dmckinnon/PicoGPT/README.md

# PicoGPT
I’ve wanted to learn more about the optimisation techniques that go into running modern LLMs on specialised hardware for a long time, so I recently did a technical deep dive. This involved creating and training a small (few megabytes) GPT-architecture model, which got me thinking: could I optimise such a model to run on something small? What's the smallest thing I could get a reasonable GPT to run on? 

Lo and behold, I give you a Generative Pretrained Transformer running on an ARM Cortex M33, at ~50 tokens per second generation. Let's dive in to how I achieved this.

## Contents
- [Introduction](#introduction)
- [Model structure, size, and training](#model-structure-size-and-training)
- [Porting from tflite to C++](#porting-from-tflite-to-c)
- [Can this run at all](#can-this-run-at-all)
- [Optimisations](#optimisations)
- [Circuit design and fabrication](#circuit-design-and-fabrication)
- [Conclusion](#conclusion)
- [Usage](#usage)

## Introduction
To learn deeply about LLMs I went to none other than [Karpathy](https://karpathy.ai/), his [youtube series](https://www.youtube.com/playlist?list=PLAqhIrjkxbuWI23v9cThsA9GvCAUhRvKZ) on basic LLM architecture, and of course, his [NanoGPT repository](https://github.com/karpathy/nanogpt). This is an excellent way to learn as Karpathy is clear, goes through simple steps, and the repository provides an easy playground to mess with parameters and model structure - one can see which changes affect what, like different numbers of attention heads, layers, context length, etc. The rest of this writeup assumes a considerable familiarity with the topics Karpathy goes over, Language Model architecture, Attention Heads, embedding vectors, tokens, etc. (For those who don't like youtube videos, my own writeups, mostly for my understanding, can be found [elsewhere](https://dmckinnon.github.io/LLMs-overview/) on my [site](https://dmckinnon.github.io/Tokenisation-in-LLMs/))

I'd also recently finished my [Machine Learning Business Card](https://dmckinnon.github.io/ML-Business-card/), and was struck by the thought: _could I make a NanoGPT model that ran on one of these cards?_

There's so many considerations involved in this:
- what does such a model even do? Is it too small to do anything?
- can you get a meaningful model that small? The voice recognition card has 4MB flash and ~200Kb RAM
- The base shakespeare-predictor model that NanoGPT creates, completing phrases from the works of Shakespeare based on character-tokens in a prompt, is ~40~Mb in size, with ~10 million parameters. 
- how fast will this run? My lil chip runs at 125MHz. The NanoGPT example runs on my laptop in functionally-immediate speed, but my laptop has a discrete GPU.

There's two main challenges:
1. Creating a model that can, at minimum, fit into the flash of this chip (4Mb), and probably needs to be smaller, but that also can generate coherent english sentences.
2. Getting such a model to run in real time on this tiny chip 

So, where to start? 

## Model structure, size, and training
First, can we even create a model that's really small and does something useful? I set myself a size budget of 100Kb - as in the model file (all model parameters) could not be larger than this - and twiddled with the base model. This budget comes from being ~half the RAM of the RP2040 - I'm eyeballing and thinking the code won't take much, and then we need some memory for stack, heap, etc, so 100kb seems like a good amount to aim for a priori.\ 
But what should we train it on? 100Kb model, predicting Shakespeare? That's boring, that's not much Shakespeare and also who cares. Some other pithy quotes? Amusing, but no. 

What about ... me? What if we trained the model to regurgitate facts about me? Going back to the business card idea, wouldn't it be great if my business card could just ... speak my resume to people and answer queries about that? 

I loved this idea, so I wrote up my CV, writ small (100Kb model, remember, it's not learning much), to use as the training set. 

### The base model
If we just run the prompts Karpathy has given us, to predict Shakespeare, then we get a model with:
- vocab size 65
- dataset length 1 million
- 6 layers in the model
- 6 attention heads
- 384 embedding dimensions
- ~ 10 million parameters
- ~40Mb in storage as float

### My model
The training data is the following:

```
David studied at UNSW Univeristy of New South Wales from 2012 to 2016\
What did he study?
He studied engineering and mathematics, focusing in robotics and computer vision 
David worked at Microsoft from 2016-2023
What did he work on?
At Microsoft he worked on HoloLens, using feature tracking.
At Microsoft he experimented with constellation tracking and non-inertial tracking
David work at startup Tetra in 2023
At Tetra he worked on ML graph passes, op implementations, and model zoo
David worked at Qualcomm in 2024
At Qualcomm he worked on ML graph passes and op implementations
```

dataset stats:
- length of dataset in characters: 582
- all the unique characters:  ,-.012346?ADHLMNQSTUWabcdefghiklmnoprstuvwxyz
- vocab size: 47 unique tokens, where each token is a single character

Couple notes:
- Why the questions? So that this could be legitimately queried, like a prompt could be those precise questions
- "doesn't this contain a lot of redundancy?". Yes. Yes it does. The tokenizer I'm using tokenises by characters. I want there to be examples where the characters "experimented" follow "he", but also the characters "studied" follow "he", and so on and so forth. 
- This is succinct because the model is 100kb at most, like I really have to squish it down
- Could we have more? Not sure, let's start here. I wasn't sure at the time how good a 100Kb model would be. Worst case is we overfit to this, and if this happens, I'll train on a bigger dataset

I played around with parameters. How many heads? How many embedding dimensions? How many layers? There are so many experiments to run, and I definitely did not exhaustively find the best set of parameters. But that's not my goal - I just want _something that works_. I found that the following worked:

- 1 attention head per layer
- 2 layers
- 32 embedding width
- context length 31, using a sliding window context
- 27,232 parameters
- 107Kb in storage as float

By "worked" here I mean:
- it produced reasonable predictions when prompted ... although to be honest, it's so overfit it's just regurgitating the training data. TODO examples
- it "fits" within the memory budget I have: 100Kb (ok it's 107Kb but this is close enough, I'm going to work with it)

This is a good start! Maybe I want to return to this step for a better model, but this easily fits within the flash we have - 4Mb, the matrices for individual steps fit within the RAM budget, and the results look good. So before I stress too much over getting the perfect model, let's attempt implementation. 

## Porting from tflite to C++
When running the model in NanoGPT's sample.py, there are two parts. One is the actual forward pass of the transformer, which produces a vector of logits, and the other is a loop that runs softmax over these logits, finds the probability of each vocab entry (token), samples from a distribution to get the next token, and then runs the next forward pass over the new token set. 

The first part, the actual forward pass of the transformer, is the model inference and it's here we use the model weights. The rest is just math. So to extract the model - the set of all weights, and structure of tensors and operations - in sample.py I use the following python code, where `model` is the `torch.nn` object whose `forward` function is the transformer pass inside the `mode.py` `generate` function:

```
traced = torch.jit.trace(model, x)
torch.jit.save(traced, "traced_model.pt")
```

This produces a pytorch file. Are we going to manually copy the weights from this? Well, no.\
Pytorch files are not particularly well optimised, having many redundant layers like transposes that are later cancelled by other transposes, or cast ops to int, or whatever:

[](pytorch.png)

I'd like to clean this model up, and made it easier to understand, for starters. Qualcomm has this marvellous platform called [Qualcomm AI Hub](https://workbench.aihub.qualcomm.com/) that can [optimise a model for a device](https://workbench.aihub.qualcomm.com/docs/hub/compile_examples.html).\
(Disclosure: no, I'm not sponsored by Qualcomm. I used to work on this product, however, and just genuinely think it's really useful)\
While the device I'm optimising for isn't available - they only have a selection of Qualcomm chips, funnily enough - this doesn't matter. All I'm really hoping to do is to strip the unnecessary layers from the model. We run it through their platform 

[](tflite1.png)

[](tflite2.png)

[](tflite3.png)

and now we have a tflite file! This is considerably cleaner, so the Qualcomm optimisation pass was worth it, even just for readability. From this we can identify the different parts of the transformer in each layer and consider the code for each part. 

### Layernorm
- the [layernorm](https://docs.pytorch.org/docs/2.15/generated/torch.nn.LayerNorm.html) op. Straightforward elementwise mathematical operation. (TFLite does not natively have a Layernorm op, and so breaks this out into constituent operations). This is\
$y=\frac{x-\bold{E}[x]}{\sqrt(Var[x]+\epsilon)}\times\gamma +\beta$\
The point of this operation is to normalise the data after each other operation, so there's a few of these.

```
for (size_t seq = 0; seq < seq_len; seq++) {
    const float* input_row = input + seq * embed_dim;
    float* output_row = output + seq * embed_dim;
    
    // Compute mean
    float mean = 0.0f;
    for (size_t i = 0; i < embed_dim; i++) {
        mean += input_row[i];
    }
    mean /= embed_dim;
    
    // Compute variance
    float variance = 0.0f;
    for (size_t i = 0; i < embed_dim; i++) {
        float diff = input_row[i] - mean;
        variance += diff * diff;
    }
    variance /= embed_dim;
    
    // Normalise
    float inv_std = 1.0f / sqrtf(variance + epsilon);
    for (size_t i = 0; i < embed_dim; i++) {
        output_row[i] = gamma[i] * (input_row[i] - mean) * inv_std + beta[i];
    }
}
```

### Q/K/V
- Q/K/V matrix multiplications with the embedding vectors. Matrix $\times$ vector, simple. By keeping the vectors consecutive in memory, we create a matrix, and can just use our matrix multiplication function to do this:

```
static inline void matmul(
    const float* A, size_t rows_a, size_t cols_a,
    const float* B, size_t cols_b,
    float* C
) {
    for (size_t i = 0; i < rows_a; i++) {
        for (size_t j = 0; j < cols_b; j++) {
            float sum = 0.0f;
            for (size_t k = 0; k < cols_a; k++) {
                sum += A[i * cols_a + k] * B[k * cols_b + j];
            }
            C[i * cols_b + j] = sum;
        }
    }
}

// Then to actually do the QKV projection:

const float* q_weights = qkv_weights;                           // [0:embed_dim, :]
const float* k_weights = qkv_weights + embed_dim * embed_dim;   // [embed_dim:2*embed_dim, :]
const float* v_weights = qkv_weights + 2 * embed_dim * embed_dim; // [2*embed_dim:3*embed_dim, :]

// Project to Query
matmul(input, seq_len, embed_dim, q_weights, embed_dim, query);

// Project to Key
matmul(input, seq_len, embed_dim, k_weights, embed_dim, key);

// Project to Value
matmul(input, seq_len, embed_dim, v_weights, embed_dim, value);
```

### Scaled Self-Attention
- Scaled self-attention\
[image]
This is the key attention equation:\
$Attention(Q, K, V) = softmax(\frac{QK^T}{\sqrt{d_k}})V$\
We could break this down further into a matrix multiplication, a scaling, and another matrix multiplication, but I think it's better to keep it all as one function because then we can smoosh a bunch of things together. 

```
static inline void softmax(float* input, float* output, size_t length) {
    // Find maximum value for numerical stability
    float max_val = input[0];
    for (size_t i = 1; i < length; i++) {
        if (input[i] > max_val) {
            max_val = input[i];
        }
    }
    
    // Compute exponentials and sum
    float sum = 0.0f;
    for (size_t i = 0; i < length; i++) {
        output[i] = expf(input[i] - max_val);
        sum += output[i];
    }
    
    // Normalize
    for (size_t i = 0; i < length; i++) {
        output[i] /= sum;
    }
}

// then to perform attention

const float scale = INV_SQRT_HEAD_DIM; // 1/sqrt(embed_dim)
    
// Compute Q * K^T / root(embed_dim)
// query: [seq_len, embed_dim], key^T: [embed_dim, seq_len] -> scores: [seq_len, seq_len]
for (size_t i = 0; i < seq_len; i++) {
    for (size_t j = 0; j < seq_len; j++) {
        float sum = 0.0f;
        for (size_t k = 0; k < embed_dim; k++) {
            sum += query[i * embed_dim + k] * key[j * embed_dim + k];
        }
        attention_scores[i * seq_len + j] = sum * scale;
    }
}

// Apply causal mask and softmax for each query position
for (size_t i = 0; i < seq_len; i++) {
    float* score_row = attention_scores + i * seq_len;
    
    // Apply causal mask (can only attend to previous and current positions)
    for (size_t j = i + 1; j < seq_len; j++) {
        score_row[j] = -INFINITY;
    }
    
    // Apply softmax to this row
    softmax_inplace(score_row, seq_len);
}

// Apply attention weights to values: output = attention_scores * value
// attention_scores: [seq_len, seq_len], value: [seq_len, embed_dim] -> output: [seq_len, embed_dim]
for (size_t i = 0; i < seq_len; i++) {
    for (size_t j = 0; j < embed_dim; j++) {
        float sum = 0.0f;
        for (size_t k = 0; k < seq_len; k++) {
            sum += attention_scores[i * seq_len + k] * value[k * embed_dim + j];
        }
        output[i * embed_dim + j] = sum;
    }
}

```

### Feed-Forward Network
- Feed Forward Network [image]. This is just a matrix multiplication (`Fully Connected`), a [GELU](https://docs.pytorch.org/docs/2.15/generated/torch.nn.GELU.html) elementwise operation, and then another matrix multiplication. A lot of matrix multiplication happening all over the place, so an obvious point to start improvements.

```
matmul(input, seq_len, embed_dim, up_weights, ffn_dim, hidden);
    
// Apply GELU activation in-place
apply_gelu(hidden, seq_len * ffn_dim);

// Second linear layer: output = hidden * down_weights  
// hidden: [seq_len, ffn_dim], down_weights: [ffn_dim, embed_dim] -> output: [seq_len, embed_dim]
matmul(hidden, seq_len, ffn_dim, down_weights, embed_dim, output);
```

### Residual Skip Connection
This is the `Add` operation joining those two branches together. We take the input to the whole layer, before any attention or feed-forward, and add it with the output of the whole layer.

```
static inline void add_tensors(
    const float* A,
    const float* B,
    float* C,
    size_t length
) {
    // Yeah this one's pretty simple
    // The vectors are so short it's practically not worth optimising
    for (size_t i = 0; i < length; i++) {
        C[i] = A[i] + B[i];
    }
}

// This comes in after FFN, for example
float* ffn_output = ffn_op(arena, normalized_input, up_weights, down_weights, 
                              seq_len, embed_dim, ffn_dim);
size_t total_elements = seq_len * embed_dim;
add_tensors(input, ffn_output, output, total_elements);
    
```

### Gather
This is simply indexing into an array. "Here's some indices for vocab elements, get the vocab elements they refer to".

### Putting it all together
Now all we need to do is connect those parts ... 

```
// inside Attention with residual:
qkv_projection(input, qkv_weights, query, key, value, seq_len, embed_dim);
    
// Step 2: Scaled Dot-Product Attention
scaled_dot_product_attention(query, key, value, attention_output, 
                            attention_scores, seq_len, embed_dim);

// Step 3: Output Projection
attention_output_projection(attention_output, output_weights, final_output, 
                               seq_len, embed_dim);

// Step 4: residual
size_t total_elements = seq_len * embed_dim;
add_tensors(input, attention_output, output, total_elements);

// inside FFN with residual:
layer_norm(input, normalized_input, ln_gamma, ln_beta, seq_len, embed_dim, LAYER_NORM_EPS);
float* ffn_output = ffn_op(arena, normalized_input, up_weights, down_weights, 
                              seq_len, embed_dim, ffn_dim);
size_t total_elements = seq_len * embed_dim;
    add_tensors(input, ffn_output, output, total_elements);

// Running one full layer:
// (repeat for n layers, and update parameters accordingly)
float* attn_output = attention_with_residual(
    arena, input, attn_qkv, attn_out, ln_gamma_1, ln_beta_1,
    seq_len, config->embed_dim
);

// FFN with residual connection
float* layer_output = ffn_with_residual(
    arena, attn_output, ffn_up, ffn_down, ln_gamma_2, ln_beta_2,
    seq_len, config->embed_dim, config->ffn_dim
);

```

and thats the whole model! 

## Can this run at all

Is it actually that simple? Well, let's see if this runs at all. For my first ML-on-business-card I used the [RP2040](https://pip-assets.raspberrypi.com/categories/814-rp2040/documents/RP-008371-DS-1-rp2040-datasheet.pdf), but it does software emulation of floating point hardware - that is, floating point math is actually done with 32-bit integers emulating what a dedicated floating point logic gate circuit would do. Software-floating-point will work, but be slow. Coincidentally, the next generation, the [RP2350]() chip had just come out, and this one came with a FPU coprocessor - floating point hardware! So floating point arithmetic could be performed in a single clock cycle. A dev board was acquired, a compiler was run (and run and run and run and eventually the code compiled), a chip was flashed, aaaaaand ...

|Input context length |	Time per next token |	Tokens/second
|---|---:|---:|
|5 tokens |	25.473 ms |	39.26
|7 tokens |	30.128 ms |	33.19
|10 tokens |	37.315 ms |	26.80
|31 tokens |	92.209 ms |	10.85

10 tokens per second!! For a basic implementation, that's a lot more than I was expecting. I'm ignoring the low context lengths, because those are not particularly useful. We want full sentences, and when a single token is a single character ... 5 characters doesn't get you much. 31 characters does. 

So, what do we do from here? Is this it? It runs, produces sentences, yay done move on?\
Absolutely not! Now we need to see just how fast we can get this model running. The main metric I'll use is tokens per second on prompt processing and decode processing, but as decode is a fixed 31-length sliding window, it doesn't make much of a difference. 

There are a number of optimisations I have in mind: multithreading, unrolling, removing intermediates, RAM residency, quantisation. The next section will go through everything I tried, including failures. 

## Optimisations

There are several benchmarks I'm using here. For some things like matrix multiplication, we can easily create a standalone benchmark. I'm also giving the model a small prompt and generating 100 output tokens based on this prompt, and we'll see how that is affected each time. 

All optimisations were also checked for accuracy, both on numerical benchmarks (computing matrices etc) and also checking token-generation output. While the output logits (the values directly from the final layer) changed slightly, the difference was never enough to change the final probabilities for each token, for the next prediction. Only optimisations that maintain this accuracy are considered. 

There are a couple of optimisations some notice are missing here; namely, quantisation and KV caches. I did consider these and ultimately rejected, and I'll address that briefly:
- Quantisation.\
Quantisation involves squashing my nice and accurate floating points into discrete little int8s. The advantages of this are namely storage - I could have four times as many parameters for the same flash size - and processing speed, as I could use the M33's DSP to do SIMD operations on int8 data, computing 4 results within one clock cycle. However, there's an accuracy cost to quantisation, and given the speeds I ended up getting with floating point, I did not consider the accuracy hit worthwhile at this stage. Perhaps for V2, where I want to attempt a bigger model.
- KV Cache\
One common optimisation in the LLM-implementation field is that of a KV cache. When generating tokens after the prompt, since we have already run over the attention of previous tokens to other previous tokens, this does not need to be recomputed, so we, well, cache the result of this and simply compute the K/V results for any new tokens. I decided against this one. Firstly, when generating tokens, I use a sliding window context of 31 tokens - therefore, any results older than 31 tokens become irrelevant, and we need to recompute the 31-token attention anyway, or do complex cache management. Recomputing is easier. Secondly, 31-token context is simply not large enough to warrant the complexity of a KV cache.

### Cache-coherent matmul
Both attention and Feed-Forward Networks rely on matrix multiplication. My thought was that to optimise for cache-coherency, as matrices tend to be stored linearly, we could write out one row of output at a time - keeping the whole row in cache - and therefore keep one row of matrix $A$ in $C = A\times B$ resident in cache as well, whilst iterating through the columns of B. That second iteration would have cache misses, but no more so than a regular iteration keeping one column of B, iterating through rows of A and rows of output. 

A nice idea in theory; it turns out, from the [datasheet](https://support.arm.com/documentation/100230/latest/) that the ARM Cortex M33, that the RP2350 is based on, has no CPU cache, and therefore ... this is irrelevant. Oh well. A nice idea.

### SRAM Residency
The RP2350 fetches weights from flash and places them into SRAM to do the matrix calculations. There is a 16 KiB cache for this, buuuuut ... what if we avoided that fetch? Each fetch from flash has a delay due to the cache (could have a miss) and the QSPI memory interface. It's not large, but we have 500Kb of SRAM and a 107Kb model. We can fit this entirely within RAM once upon startup - incurring a one-time cost - but then reuse weights with abandon, processing as many new tokens as we see fit without any extra fetch overhead. 

To achieve this, we just use a linker setting: `-DPICO_DEFAULT_BINARY_TYPE=copy_to_ram`\
Or in CMake, `pico_set_binary_type(PicoGPT copy_to_ram)`. \
This then copies all application code and constants, like weights, into SRAM upon boot. We could manually write a copy, but I prefer to not reinvent the wheel (or the memcpy).

Here's the timing, with and without:
|Configuration	|Time per token, 31-token context|	Tokens/s|
|---|---:|---:|
| baseline, flash/XIP|	79.852 ms|	12.52|
|SRAM code + weights|	63.907 ms|	15.65|

A considerable improvement! An expected one, but nonetheless rewarding to see. 

### Unrolling
This is essentially pipelining loops. Consider a standard matmul loop:

```
for (B matrix rows)
    for (A matrix cols)
        for (C matrix position)
            C[i,j] += a*b
```

In the inner-most loop, we do one multiplication, one addition, one store, and then check loop conditions, have a potential branch, and set up the loop again. There's almost as much overhead as there is loop calculation!

What if we were to do more per loop? Consider:

```
for (B matrix rows)
    for (4 A matrix cols)
        for (4 C matrix positions)
            C[i_1,j_1] += a_1*b_1
            C[i_2,j_2] += a_2*b_2
            C[i_3,j_3] += a_3*b_3
            C[i_4,j_4] += a_4*b_4
```

We've essentially batched this matmul, doing 4 at a time. Obviously this requires the size to be divisible by 4, but we know the size a priori so we can make this work. Now we do 4 multiplications and 4 additions per loop overhead! The multiplications in the Floating Point coprocessor take a couple of cycles, but there are multiple floating-point registers we can use so these multiplies can be pipelined so we hide the delay on those registers behind the next multiply:

```
Example with unrolling 2 at a time

Before:
cycle 1: R0 = R1*R2
cycle 2: R0 locked behind second cycle  of multiply, nothing happens
cycle 3: R4 += R0
cycle 4: loop stuff

After:
cycle 1: R0 = R1*R2
cycle 2: R0 locked, R5 = R6*R7
cycle 3: R4 += R0, R5 locked
cycle 4: R8 += R5
cycle 5: loop stuff
```

In this 'after', there's no cycle where we are just waiting - we're always doing something. This may seem small, but recall it's the inner loop of three nested loops so this happens a lot. And that's just one matmul, of three matmuls per layer, for two layers, per token. The time saving should add up. 

Does it? Let's take a look at the results:

|Configuration|	Time/token|	Tokens/s|	Speedup vs flash baseline|
|---|---:|---:|---:|
|Flash/XIP baseline|	79.852 ms	|12.52	|1.00×|
|SRAM code + weights|	63.907 ms|	15.65|	1.25×|
|Four-way matmul unrolling: FFN and attention projections|	40.826 ms	|24.49	|1.96×|

As expected, we get gainz. That's enormous though! 

What can be unrolled?\
Any loop, really. Matrix multiplications, elementwise operations like tensor addition or GELU, parts of the softmax function. Unroll everything! I realised later that I had forgotten some of the loops to unroll here, and so our speedup is technically even more.

### Fused Multiply-Accumulate
Can we make the inner loop of matmuls even faster? Until now, this inner loop of the matrix multiplication has been using two instructions: floating point multiply, and floating point add. \
But there's an important feature in this floating point coprocessor: [Fused Multiply-Accumulate](https://pip-assets.raspberrypi.com/categories/1214-rp2350/documents/RP-008373-DS-3-rp2350-datasheet.pdf), also known as `FMA` (Section 3.7.2.4).

This does exactly as it sounds, performing a multiply and accumulate (+=) all in one instruction. This should make our inner loop have half the number of instructions! That's twice as fast! It's a relatively simple change, just a compiler flag:

```
# Specifically, the ffp-contract=on is the FMA.
target_compile_options(PicoGPT PRIVATE
    -Wall -Wextra -O2 -fstack-usage -ffp-contract=on
)
```

And this will replace floating point multiplies followed by accumulates with the single instruction. 

Check results, and note that this is on top of unrolled loops:

|Measurement|	FMA off|	FMA on|	Change in elapsed time|
|---|---:|---:|---:|
|Scalar attention-projection matmul	|1.836 ms	|1.624 ms	|11.5% less|
|Four-way attention-projection matmul|	0.945 ms|	1.168 ms|	23.6% more|
|Four-way FFN-up matmul	|3.767 ms|	4.659 ms	|23.7% more|
|Generate 100 tokens, inference only	|3.432 s|	3.612 s|	5.2% more|

Oh.\
This is slower, overall.\
Hmm. \
Why is this slower?

I dug a bit but not enough to properly figure it out. It was faster than the single-multiple-accumulate per loop, but not faster than unrolling. My theory is that it uses more registers and slowed down the unrolled version with register swaps? No evidence to support this. I could dig into the assembly, but we got such a massive win from unrolling and there's more to try that if all else fails I'll come back, but otherwise ... meh. Chalk this one up as a loss. 

### Removing Intermediates/Fusing
The concept behind this idea is that we are constantly performing an operation, like adding two tensors, and then writing the result out to a third tensor in memory. The next operation will read this back from memory, perform something else on it, like some elementwise operation, and then write it back out again. \
There's a lot of inefficiency here. What if we fused the two? That is, what if we didn't have the intermediate tensor?\
For example, after FFN we have the residual skip-layer, where we add the tensor from the start of the layer back into the result from the layer. We could complete the matmul, write that out, and then loop through the tensor again and element-wise add. \
Or\
We could, while performing the matmul, add the residual to the layer-input tensor at the output of the matmul, and thereby avoid a whole separate iteration through the tensor?

Let's see this in code:

```
Before:
for (rows of B)
    for (cols of A)
        for (elems in dot product)
            C[i] += a*b

for (elems in tensor)
    C[i] += input[i]

After:
for (rows of B)
    for (cols of A)
        for (elems in dot product) 
            C[i] += a*b
            C[i] += input[i]
```
We still have to do all the operations, but what this saves is all the loop overhead - not just in an unrolling fashion, but ALL the loop overhead of a second loop. \
We can do this for the two residual skip-connections, and also the GELU operation in the middle of the FFN. 

Let's check these separately:

|FFN configuration|	Full-context time/token	|Tokens/s|	100-token inference|
|---|---:|---:|---:|
|Before fusion|	40.826 ms	|24.49	|3.432 s|
|Buffer reuse + fused residual and fused GELU|	41.863 ms	|23.89	|3.517 s|
|Buffer reuse + fused residual, separate GELU	|40.330 ms	|24.80	|3.388 s|

So the skip connection fusing works, albeit for a marginal gain. Why doesn't GELU? GELU uses the [C++ `erff` function](https://en.cppreference.com/cpp/numeric/math/erf), which is register heavy. This works on its own, but when we are trying to preserve four separate accumulated values ... that costs extra registers which therefore cannot be used during a register heavy function. I didn't dig into the assembly here, but my best guess is that there was some use of SRAM to hold register values while `erff` was computed, reducing time savings under fused-unrolling.

Oh well. We can still unroll the GELU on its own and get an already-proven win there - that is, finish the unrolled matmul, save an intermediate, perform GELU unrolled on its own loop (so each of four `erff` calls in the loop has full register access), and then move on to the next matmul. How does this perform?

|Configuration|	Time/token	|Tokens/s	|Speedup vs flash baseline|
|---|---:|---:|---:|
|Flash/XIP baseline	|79.852 ms|	12.52	|1.00×|
|SRAM code + weights|	63.907 ms|	15.65	|1.25×|
|Four-way matmul unrolling: FFN and attention projections|	40.826 ms	|24.49|	1.96×|
|FFN buffer reuse, fused residual, separate GELU|	40.330 ms	|24.80	|1.98×|

The fused residual is a pretty small gain, but again - doesn't hurt us, doesn't overly complicate the code, so I'm going to keep this in.

### Multithreading
Another seemingly obvious win. Until now, all algorithms have run on a single core - which we needed to clearly know what the speedup was, so this one has to come last. 

The Cortex M33 has two cores, each with a floating point coprocessor. There are no CPU caches, as mentioned previously, and both cores just read and write directly to SRAM. All we need to do is split the loops we intend to multi-thread correctly so no memory contention occurs, and this should just fall into place. We'll multithread the matrix multiplication loops - unrolled and with fused intermediates, so this means multithreading several implementations - and try the elementwise GELU loop. The softmax ... is finicky enough and doesn't take enough time for this to be worth it. I profiled the whole thing, and matmul dominates. Softmax was a mere 5% of time, to the ~60% of time spent on matmul. 

How should we split up the matrix multiplication? GELU loop is easy - first half to one core, second half to other core. Matrices, though - the cores need to share one matrix entirely. \
The way that sounds best on paper is, for $C = A\times B$, to split $A$ between the two cores, share $B$, and then also split the output $C$. The split would occur vertically through the matrix:

$$
C = AB =
\left[\begin{array}{c}
A_1 \\ \hline A_2
\end{array}\right] B
=
\left[\begin{array}{c}
A_1 B \\ \hline A_2 B
\end{array}\right]
=
\left[\begin{array}{c}
C_1 \\ \hline C_2
\end{array}\right]
$$

where $A_1, A_2 \in \mathbb{R}^{(m/2) \times k}$ and $C_1, C_2 \in \mathbb{R}^{(m/2) \times n}$. Thread $i$ computes $C_i = A_i B$.

This works because $A$ is laid out row by row in memory, so by giving the first half of the rows to one core, we give it a contiguous memory block, and the second half of the rows is also one contiguous memory block going to the second core. There's no memory contention or overlap. $C$ is laid out the same way.\
There's some nuance I'm brushing over here with setting up the second core to run, passing jobs to it, etc, but we don't need to go into that. The code is simple enough, and the point here is the theory of splitting and multithreading.

Let's take a look at the results:

|Execution	|Full-context time/token|	Tokens/s	|100-token inference|
|---|---:|---:|---:|
Single core|	37.862 ms|	26.41	|3.195 s|
Two cores	|24.018 ms	|41.64	|2.024 s|

A clear win. We didn't really expect anything else - doing half the work simultaneously with the other half of the work, with minimal overhead.

### Ignoring unused output
Almost an afterthought, this one. In the base implementation, we compute a whole vector of output logits, softmax to get the probabilities per index, and then choose a token per index. But previous indices have already been computed! We only need the last token. 

Simple: don't softmax the whole vector, just the last entry, and then only compute for this token. Removes unneeded compute. 

Let's check the speedup we get:
|Measurement|	Before	|Last-position-only output|
|---|---:|---:|
|Full-context time/token	|24.018 ms|	20.779 ms|
|Tokens/second	|41.64	|48.13|
|100-token inference	|2.024 s	|1.749 s|

Saves a few hundred milliseconds over the 100 token generation. Not terrible, not great - much like reading 3.6 roentgens on a dosimeter. But it causes no harm, and it is objectively faster, so we'll keep it. 

For now, I'm considering optimisation done.

## Circuit design and fabrication
I'm using the same basic concept for the board as with my previous [card](https://dmckinnon.github.io/ML-Business-card/) - the USB C port in the corner, thin enough to slot into a USB male connector. There's a couple of big differences:

<image>

1. This uses the RP2354, not RP2350. What's the difference? The 2354 has 2MB of flash built in, instead of needing an external flash chip. It's not much, and I have spare flash chips sitting around, but it makes circuit design and routing just that little bit simpler
2. I'm breaking out all the rest of the chip's GPIO. The intention here is that this board is reusable as a Raspberry Pi Pico 2 dev board, just a nice touch to whoever you give this away to, OR if I just happen to need another dev board and my main one is tied up in another project. Reusability is nice. 

I used [PCBWay](https://www.pcbway.com) for fabrication. I've talked about [using them before](), and choose them each time. It's such an easy interface and experience:



- to get a quote, just put in board dimensions and other details like colour, and approximate price is ready for you
- to get the board itself, [export and upload all necessary files from KiCad](https://www.pcbway.com/blog/PCB_Design_Tutorial/How_to_Export_Gerber_and_Production_Files_in_KiCad.html) - there might be some clarification but they'll help you through issues
- board is at your door not long after. They even have the option of doing all the components for you (i still do this myself, but it's just a preference)\

Here's the finished board! 

TODO add image
<image>

It's easy to flash, and I'm really happy with Raspberry Pi for this one - holding the BOOTSEL button puts it in flashing mode and it appears as a storage device on the computer. Drag and drop the binary, it reboots, and then runs. See below for [Usage](#usage)

## Conclusion
I'm really pleased with how this turned out. I never got to the original idea that kicked it off - using the DSP to accelerate a quantised version to reasonable speeds - but this was still fun. This project started with more than 5 seconds for generating a hundred tokens, and ended up with 1.7s.\
The model is definitely smaller than it could be, and considerably overfit, so it comes across as too regurgitative of the training data. But the optimisations drastically speed things up, and that proves a good initial point - I could use a much bigger model, and still get reasonable speed. \
Other tech workers have seen this demonstrated and were delighted or impressed at the concept and execution, also proving the point that it's a useful exercise and gets the attention of a potential hiring manager. 

### What next
As mentioned, the model is small and overfit, and runs far faster than necessary. Given that the chip I used has 2Mb flash, what I'd like to try next is a _much_ bigger model - perhaps a whole megabyte, perhaps even more. I'd practically write my biography, so far more detail and training data, and have it learn that to answer any query deeply. Then there's problems to reckon with like paging the weights in and out of flash with one core while the other core performs matmuls, and we might need to make more serious optimisations, cos there's so much more model to process. It'll run a whole lot slower, but this would be a fun test of just how big I can go and maintain something like, say, 10 tokens per second generation speed. 

### A note about AI usage
Generative AI was used in this project. There's an open philosophical discussion about how much that makes this "my" project vs ... well, who do we credit for the AI part? The data it trained on? Anyway, the point here is not to reopen that box ...\
How was it used?\
I did some code generation, but crafted the main ideas, and hand-wrote some of the code myself. Let me give some examples:

- "I'd like to try unrolling the matmul loops. Instead of just accumulating one value per loop, let's try four. Can you implement this on each matmul loop and also the loop that performs the GELU?"\
I see this as my idea and thought process, and just me skipping the mechanical effort of adding in
```
C[i_1] += a_1*b_1;
C[i_2] += a_2*b_2;
C[i_3] += a_3*b_3;
```
multiple times across several files. We all know that's error prone and not fun. The agent may have made an error, but I can review this pretty quick as its a small project.

- I wrote the original multithread code that split the matrices and ran the second half on the second core, for one matmul, and then asked the agent to do the same for the matmul-with-residual impl, and also tidy up the interface. It suggested an improved way; I went with this.

- More abstractly, I asked for a build script, and some pretty-printing of results so I could read them better. I've handwritten a lot of `printf` stuff in the past; I don't want to manually do all that again. 

We can quibble back and forth about how much this makes this "my" project, but I at least wanted to be clear about the workload split. 

## Usage

### Build and serial usage

FIX THE BELOW NONSENSE
### Makefile versus CMake

There are two build entry points in [PicoGPT/](PicoGPT/), targeting different
machines:

| Entry point | Purpose | Output |
|---|---|---|
| [Makefile](PicoGPT/Makefile) | Hand-written rules for native GCC, tests and extraction | Linux/host executables such as `gpt_model` |
| [CMakeLists.txt](PicoGPT/CMakeLists.txt) | Configure the Pico SDK, cross-compiler, board, libraries and memory layout | RP2350 firmware: ELF, UF2, map file |

Make executes build rules. CMake generates those rules for a backend such as
Make or Ninja. Thus the Pico build can also contain a generated Makefile,
but it is not the hand-written host Makefile. Use `cmake --build <directory>`
so CMake invokes the correct backend; plain `make` in this source directory
builds the host program, not the Pico firmware.

The [shell wrapper](PicoGPT/build_and_run.sh) now deliberately builds and runs
the native host demo. Firmware must be copied to the Pico rather than executed
as a Linux program.

Native commands (run in WSL for this checkout):

```sh
cd "$HOME/PicoGPT/PicoGPT"
make -B gpt_model
./gpt_model
# Equivalent host build/run:
bash build_and_run.sh

# Numerical tests, with the current dual-core dispatch exercised on host threads:
make parity-test PYTHON=./gpt_venv/bin/python \
  CFLAGS='-Wall -Wextra -Werror -O2 -std=c99 -ffp-contract=off -DGPT_MATMUL_UNROLL4=1 -DGPT_ATTENTION_UNROLL4=1 -DGPT_FFN_FUSE_GELU=0 -DGPT_MULTICORE=1'
```

The host demo is still a diagnostic program. The interactive USB console below
is implemented in [pico_main.c](PicoGPT/pico_main.c).

### Interactive Pico 2 firmware

Configure the SRAM-resident, dual-core, separate-GELU, unrolled implementation:

```sh
cd "$HOME/PicoGPT/PicoGPT"
cmake -S . -B build/pico-serial-2.3.1 \
  -DPICO_SDK_PATH="$HOME/.pico-sdk/sdk/2.3.1" \
  -DPICO_TOOLCHAIN_PATH="$HOME/.pico-sdk/toolchain/15_2_Rel1" \
  -DPICO_BOARD=pico2 -DCMAKE_BUILD_TYPE=Release \
  -DPICO_DEFAULT_BINARY_TYPE=copy_to_ram \
  -DPICOTOOL_FORCE_FETCH_FROM_GIT=ON \
  -DGPT_MATMUL_UNROLL4=ON -DGPT_ATTENTION_UNROLL4=ON \
  -DGPT_FFN_FUSE_GELU=OFF -DGPT_MULTICORE=ON -DGPT_PROFILE_ENABLED=OFF
cmake --build build/pico-serial-2.3.1 --parallel 4
```

SDK/compiler paths are specific to the local installation; adjust them on
another machine. The toolchain host architecture here is aarch64. The
`PICOTOOL_FORCE_FETCH_FROM_GIT` option builds the SDK's build-only picotool,
avoiding the extension-provided executable's missing `libusb` dependency in
this WSL environment. The first configuration needs network access.

After configuration, only the `cmake --build ...` command is needed to rebuild.
Use a new build directory when changing SDK/compiler versions to avoid mixing
cached paths.

The flashable image is `PicoGPT/build/pico-serial-2.3.1/PicoGPT.uf2`.
Hold BOOTSEL while connecting the Pico 2, copy the UF2 onto its RP2350 drive,
and then open the USB serial port. A 115200 baud terminal setting is conventional
(USB CDC is not clocked by that UART setting). Enable DTR, disable local echo,
and send lines terminated by CR, LF or CRLF. In WSL, Windows may own the serial
device; using a Windows terminal is fine.

On connection, the firmware shows help and `pico>`. It does **not** automatically
run benchmarks or generate text.

| Input, followed by Enter | Behavior |
|---|---|
| `/random` | Generate 100 new characters from a single newline token with a fresh seed |
| `What did he study?` | Generate 100 new characters using that exact prompt |
| `/repeat` | Reuse the last successful prompt and seed |
| `/bench` | Run matmul benchmarks, reference check, seed-42 generation and memory reports |
| `/memory` | Print current runtime memory diagnostics |
| `/profile` | Run stage and SRAM-bus profiling, if compiled in |
| `/help` | Show commands and input limits |

The former immediate `r` and `p` shortcuts are replaced by slash commands so
ordinary prompt characters are not intercepted. Commands require Enter.
Backspace/DEL edits a line; Ctrl-C cancels the **input line**, not an inference
already running. Empty lines do nothing. Wait for `pico>` before sending the
next request; there is no concurrent command-input task during generation.

Prompts must contain **1-31 characters** from the exact, case-sensitive
[47-character vocabulary](PicoGPT/gpt_vocab.c). Unsupported characters are
rejected with their byte value and position. Non-ASCII/control input and lines
longer than 31 characters are rejected as whole lines, never silently truncated.
After such an error, press Enter or Ctrl-C to start a new line. Reconnecting
clears a partially entered line.

Every successful request produces **100 new model-sampled characters**, not
100 total characters including the prompt. The model uses the latest 31 tokens
as a rolling context. Temperature remains 0.8. `/random` and custom prompts
obtain a seed from the SDK `pico_rand` API, using RP2350 entropy sources, and
print that seed. Output is sampled from model probabilities, not from a uniform
character distribution. Different seeds may still produce the same text.
`/repeat` is reproducible with the same firmware; it survives a serial reconnect,
not a power cycle. `/bench`, errors and diagnostic commands do not overwrite
the remembered prompt/seed.

### Timing and writeup measurements

Each generation prints three separate figures:

- **Model processing:** time inside `gpt_inference` across all new tokens,
  excluding sampling, output and input entry.
- **Token sampling:** time selecting tokens from the logits, including the
  sampling softmax and RNG calls, excluding text output.
- **Total generation:** elapsed generation-loop time including model calls,
  validation, sampling, output calls, context updates and bookkeeping.
  This excludes seed acquisition, the printed header, and typing the prompt;
  it does not guarantee all buffered USB output has reached the terminal.

These are elapsed times on core 0, not sums of both cores' CPU time. Inference
includes the completion wait for parallel kernels. A failed generation
explicitly reports failure, the number of characters completed, and timings
for the attempted work. Normal runs omit benchmark and arena dumps; `/bench`
retains those measurements and the fixed seed 42 for repeatable writeup runs.

An interactive profiling image is also available at
`PicoGPT/build/pico-serial-profile-2.3.1/PicoGPT.uf2`. To rebuild it, use the
same configuration command with `-B build/pico-serial-profile-2.3.1` and
`-DGPT_PROFILE_ENABLED=ON`, then build that directory. Send `/profile` and
Enter. Profiling changes code layout and timing even when capture is inactive;
use the nonprofiling image for final performance figures.

Both images retain the 144 KiB arena (observed model peak **107,216 bytes**)
and guarded 4 KiB stacks for each core. The first interactive build reserves
**311,484 bytes of main RAM** and uses **159,264 bytes of flash**. The profiling
variant reserves **315,772 bytes of main RAM** and uses **163,344 bytes of flash**.
Stack reservations are in separate scratch banks and are additional to the
main-RAM figures. These sizes are build-specific.

All 22 host tests pass in multicore mode, including numerical comparisons for
prompted generation, line limits/editing/reconnection, random-seed replay,
on-demand diagnostics, and timing accounting. AddressSanitizer and
UndefinedBehaviorSanitizer also pass. Host serial/RNG/clock shims validate logic,
not USB hardware behavior, entropy quality, or on-board timing; those still
require testing this image on the Pico.
