dmckinnon/PicoGPT/PicoGPT/CMakeLists_old.txt

# Generated Cmake Pico project file

cmake_minimum_required(VERSION 3.13)

set(CMAKE_C_STANDARD 11)
set(CMAKE_CXX_STANDARD 17)
set(CMAKE_EXPORT_COMPILE_COMMANDS ON)

# Initialise pico_sdk from installed location
# (note this can come from environment, CMake cache etc)

# == DO NOT EDIT THE FOLLOWING LINES for the Raspberry Pi Pico VS Code Extension to work ==
if(WIN32)
    set(USERHOME $ENV{USERPROFILE})
else()
    set(USERHOME $ENV{HOME})
endif()
set(sdkVersion 2.2.0)
set(toolchainVersion 14_2_Rel1)
set(picotoolVersion 2.2.0)
set(picoVscode ${USERHOME}/.pico-sdk/cmake/pico-vscode.cmake)
if (EXISTS ${picoVscode})
    include(${picoVscode})
endif()
# ====================================================================================
set(PICO_BOARD pico2 CACHE STRING "Board type")

# Pull in Raspberry Pi Pico SDK (must be before project)
include(pico_sdk_import.cmake)

project(PicoGPT C CXX ASM)

# Initialise the Raspberry Pi Pico SDK
pico_sdk_init()

# Add executable. Default name is the project name, version 0.1

add_executable(PicoGPT PicoGPT.c attention_test.c)

target_compile_definitions(PicoGPT PRIVATE ON_TARGET)

pico_set_program_name(PicoGPT "PicoGPT")
pico_set_program_version(PicoGPT "0.1")

# no_flash means the target is to run from RAM
pico_set_binary_type(PicoGPT no_flash)

# Modify the below lines to enable/disable output over UART/USB
pico_enable_stdio_uart(PicoGPT 0)
pico_enable_stdio_usb(PicoGPT 1)

# Add the standard library to the build
target_link_libraries(PicoGPT
        pico_stdlib)

# Add the standard include files to the build
target_include_directories(PicoGPT PRIVATE
        ${CMAKE_CURRENT_LIST_DIR}
)

# Add any user requested libraries
target_link_libraries(PicoGPT 
        hardware_timer
        hardware_clocks
        )

pico_add_extra_outputs(PicoGPT)
