dmckinnon/PicoGPT/assets/pytorch.png

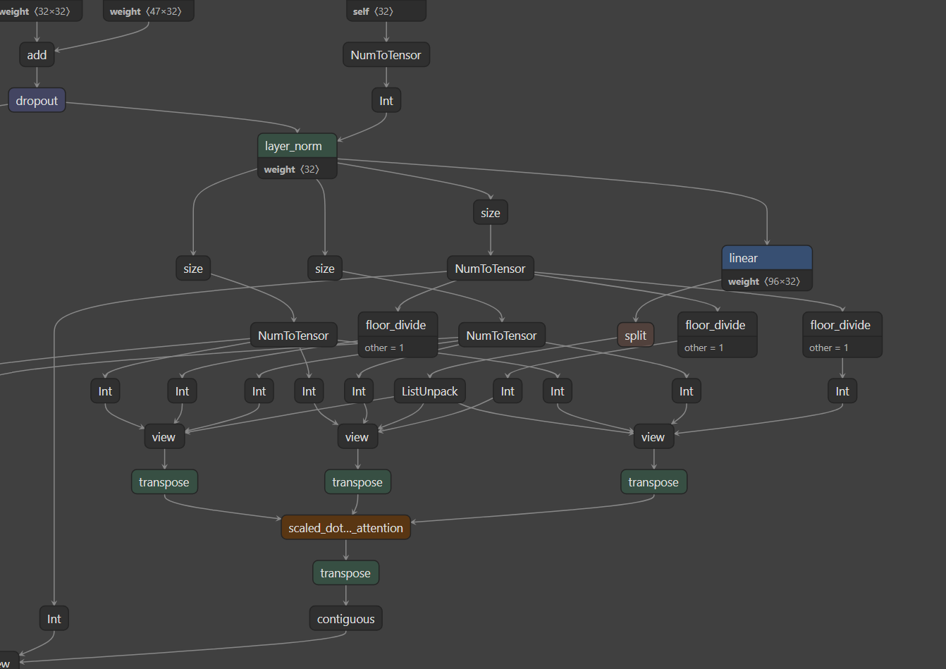
assets/pytorch.png
