dmckinnon/PicoGPT/assets/tflite1.png

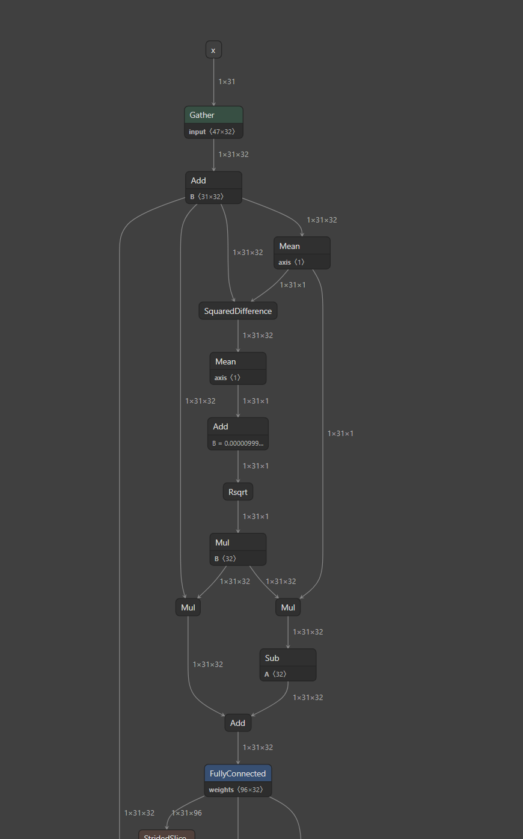
assets/tflite1.png
