dmckinnon/PicoGPT/assets/tflite2.png

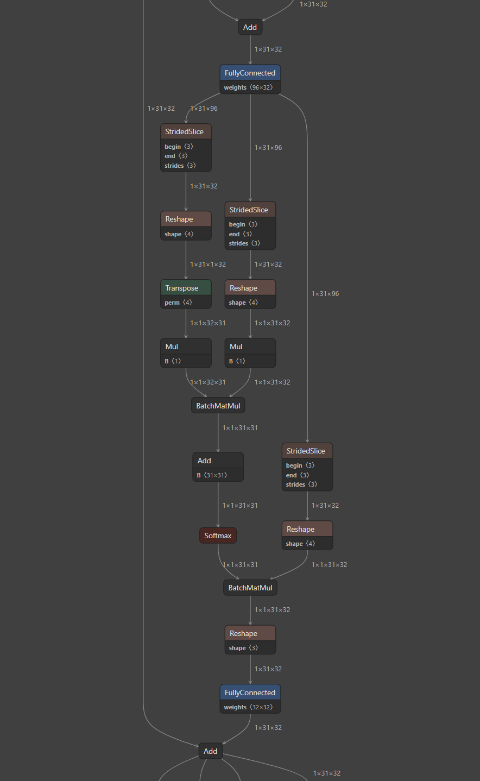
assets/tflite2.png
