dmckinnon/PicoGPT/assets/tflite3.png

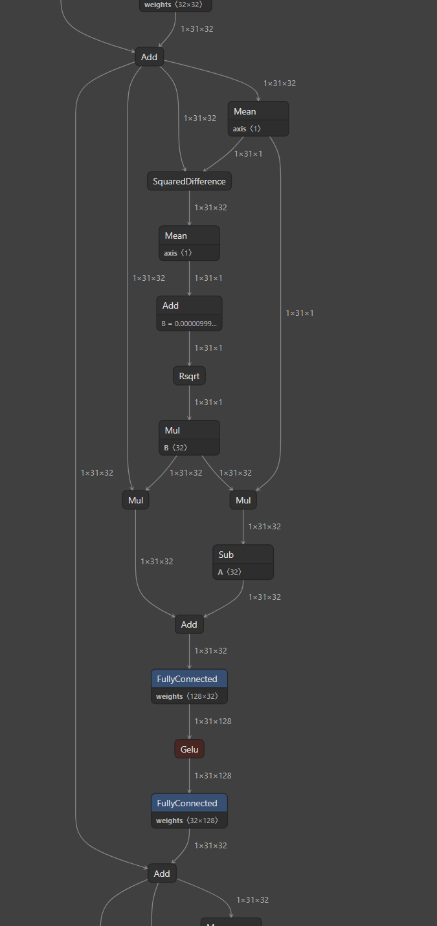
assets/tflite3.png
