dmckinnon/PicoGPT/assets/tflite4.png

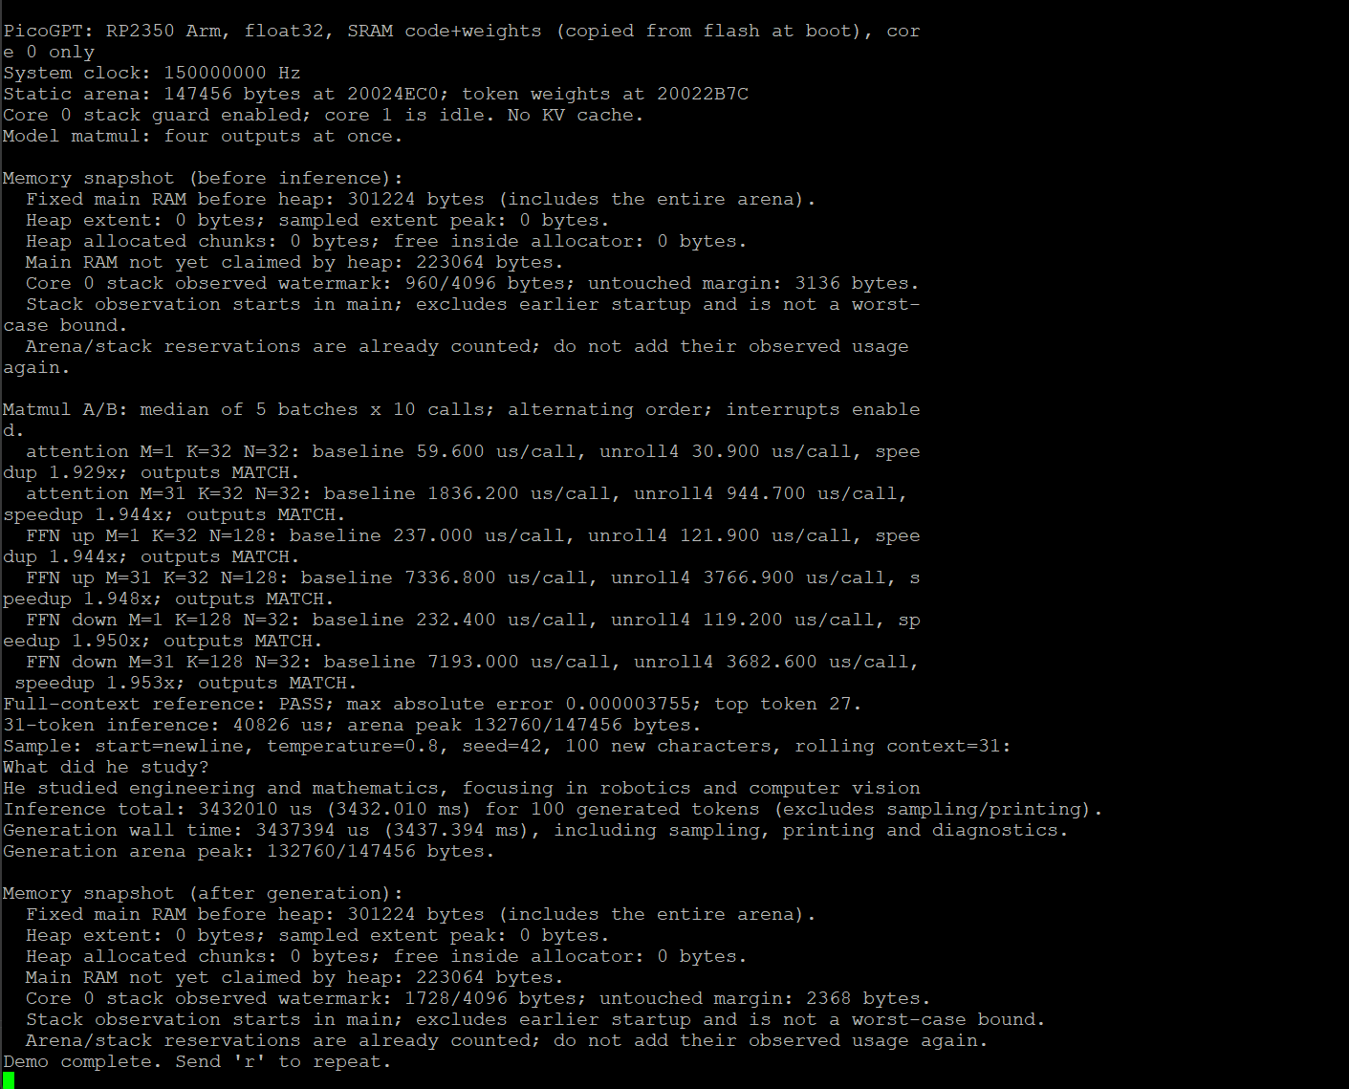
assets/tflite4.png
