dmckinnon/PicoGPT/circuit/RP2354A-main/RP2354A-main/RP2354/RP2354.kicad_pcb

## KiCad design circuit/RP2354A-main/RP2354A-main/RP2354/RP2354.kicad_pcb (2026-11-09)

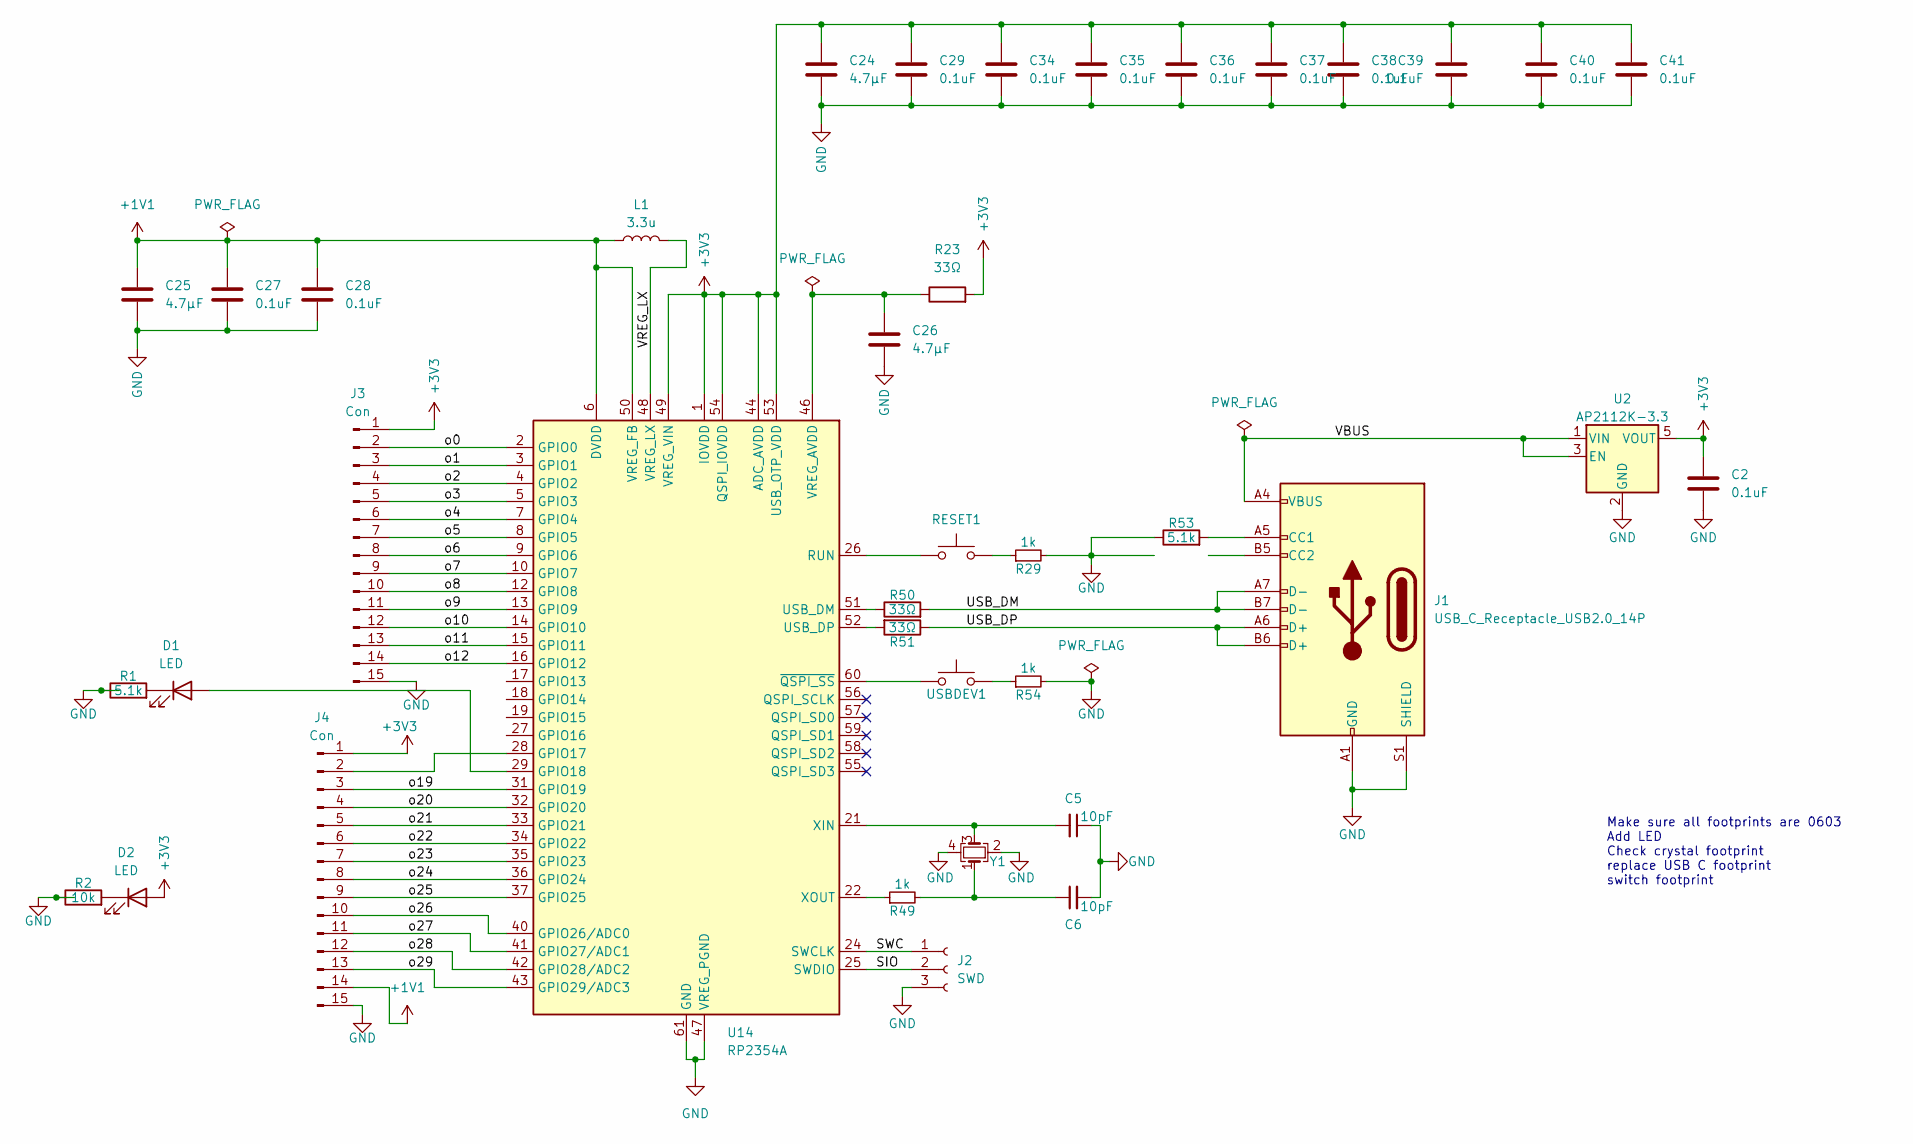
[picture p6: schematic RP2354.kicad_sch]

Parts:
C2, C27, C28, C29, C34, C35, C36, C37, C38, C39, C40, C41: 0.1uF; C_0603_1608Metric; MPN CL05B104KA5NNNC
C5, C6: 10pF; C_0603_1608Metric; MPN CL10C100JB8NFNC
C24, C25, C26: 4.7μF; C_0603_1608Metric; MPN GRM155D80E475ME47J
D1, D2: LED; LED_0603_1608Metric
J1: USB_C_Receptacle_USB2.0_14P; usb_c_board; MPN TYPE-C-31-M-14
J2: SWD; PinHeader_1x03_P2.54mm_Vertical
J3, J4: Con; PinHeader_1x15_P2.54mm_Vertical
L1: 3.3u; R_0805_2012Metric; MPN AOTA-B201610S3R3-101-T
R1, R53: 5.1k; R_0603_1608Metric; MPN RC0402FR-075K1L
R2: 10k; R_0603_1608Metric; MPN RC0402FR-075K1L
R23, R50, R51: 33Ω; R_0603_1608Metric; MPN RC0402FR-0733RL
R29, R49, R54: 1k; R_0603_1608Metric; MPN RT0603FRE101KL
RESET1: SW_Push; SW_1P1S_SMD; MPN KMR241G LFS
U2: AP2112K-3.3; SOT-23-5; MPN AP2112K-3.3TRG1
U14: RP2354A; QFN-60-1EP_7x7mm_P0.4mm_EP3.4x3.4mm; MPN SC1511(13)-A4
USBDEV1: SW_Push; SW_1P1S_SMD; MPN KMR241G LFS
Y1: Crystal; Crystal_SMD_Abracon_ABM3C-4Pin_5.0x3.2mm; MPN ABM8-272-T3

Connections:
+1V1: C25.1, C27.2, C28.2, J4.14, L1.1, U14.6 (DVDD), U14.23 (DVDD), U14.39 (DVDD), U14.50 (VREG_FB)
+3V3: C2.2, C24.1, C29.2, C34.2, C35.2, C36.2, C37.2, C38.2, C39.2, C40.2, C41.2, D2.2 (A), J3.1, J4.1, R23.2, U2.5 (VOUT), U14.1 (IOVDD), U14.11 (IOVDD), U14.20 (IOVDD), U14.30 (IOVDD), U14.38 (IOVDD), U14.44 (ADC_AVDD), U14.45 (IOVDD), U14.49 (VREG_VIN), U14.53 (USB_OTP_VDD), U14.54 (QSPI_IOVDD)
/SIO: J2.2, U14.25 (SWDIO)
/SWC: J2.1, U14.24 (SWCLK)
/USB_DM: J1.A7 (D-), J1.B7 (D-), R50.2
/USB_DP: J1.A6 (D+), J1.B6 (D+), R51.1
/VBUS: J1.A4 (VBUS), J1.A9 (VBUS), J1.B4 (VBUS), J1.B9 (VBUS), U2.1 (VIN), U2.3 (EN)
/VREG_LX: L1.2, U14.48 (VREG_LX)
/o0: J3.2, U14.2 (GPIO0)
/o1: J3.3, U14.3 (GPIO1)
/o2: J3.4, U14.4 (GPIO2)
/o3: J3.5, U14.5 (GPIO3)
/o4: J3.6, U14.7 (GPIO4)
/o5: J3.7, U14.8 (GPIO5)
/o6: J3.8, U14.9 (GPIO6)
/o7: J3.9, U14.10 (GPIO7)
/o8: J3.10, U14.12 (GPIO8)
/o9: J3.11, U14.13 (GPIO9)
/o10: J3.12, U14.14 (GPIO10)
/o11: J3.13, U14.15 (GPIO11)
/o12: J3.14, U14.16 (GPIO12)
/o19: J4.3, U14.31 (GPIO19)
/o20: J4.4, U14.32 (GPIO20)
/o21: J4.5, U14.33 (GPIO21)
/o22: J4.6, U14.34 (GPIO22)
/o23: J4.7, U14.35 (GPIO23)
/o24: J4.8, U14.36 (GPIO24)
/o25: J4.9, U14.37 (GPIO25)
/o26: J4.10, U14.40 (GPIO26/ADC0)
/o27: J4.11, U14.41 (GPIO27/ADC1)
/o28: J4.12, U14.42 (GPIO28/ADC2)
/o29: J4.13, U14.43 (GPIO29/ADC3)
GND: C2.1, C5.1, C6.2, C24.2, C25.2, C26.2, C27.1, C28.1, C29.1, C34.1, C35.1, C36.1, C37.1, C38.1, C39.1, C40.1, C41.1, J1.A1 (GND), J1.A12 (GND), J1.B1 (GND), J1.B12 (GND), J1.S1 (SHIELD), J2.3, J3.15, J4.15, R1.1, R2.1, R29.2, R53.1, R54.2, U2.2 (GND), U14.47 (VREG_PGND), U14.61 (GND), Y1.2, Y1.4
unnamed: C6.1, R49.2, Y1.1
unnamed: D1.2 (A), U14.29 (GPIO18)
unnamed: D1.1 (K), R1.2
unnamed: D2.1 (K), R2.2
unnamed: J1.A5 (CC1), R53.2
unnamed: J4.2, U14.28 (GPIO17)
unnamed 39: R29.1, RESET1.2; also elsewhere on the board
unnamed 40: R54.1, USBDEV1.2; also elsewhere on the board
unnamed 41: RESET1.1, U14.26 (RUN); also elsewhere on the board
unnamed: R50.1, U14.51 (USB_DM)
unnamed: R51.2, U14.52 (USB_DP)
unnamed: C26.1, R23.1, U14.46 (VREG_AVDD)
unnamed: C5.2, U14.21 (XIN), Y1.3
unnamed: R49.1, U14.22 (XOUT)
unnamed 47: U14.60 (~QSPI_SS), USBDEV1.1; also elsewhere on the board

Notes on the sheet:
Make sure all footprints are 0603 Add LED Check crystal footprint replace USB C footprint switch footprint

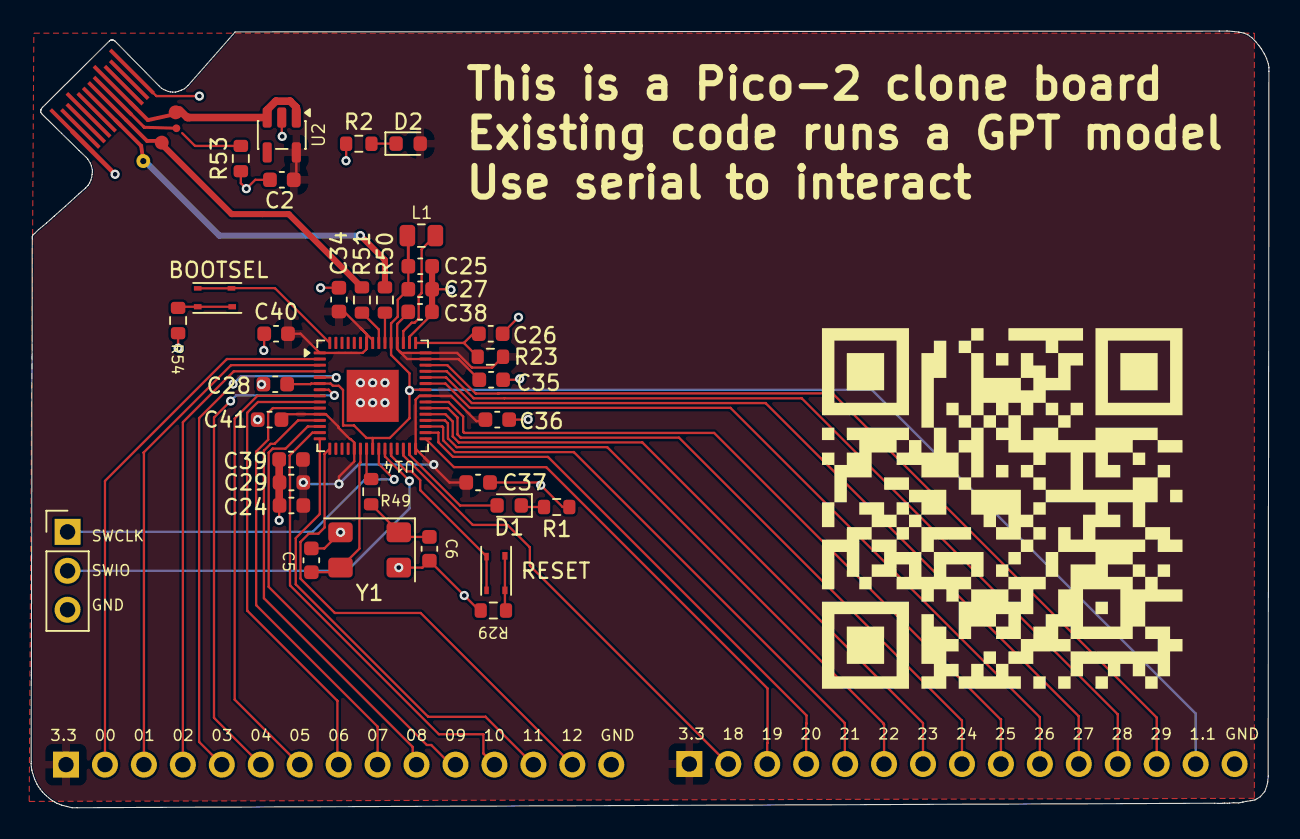
[picture p7: board RP2354.kicad_pcb from above]

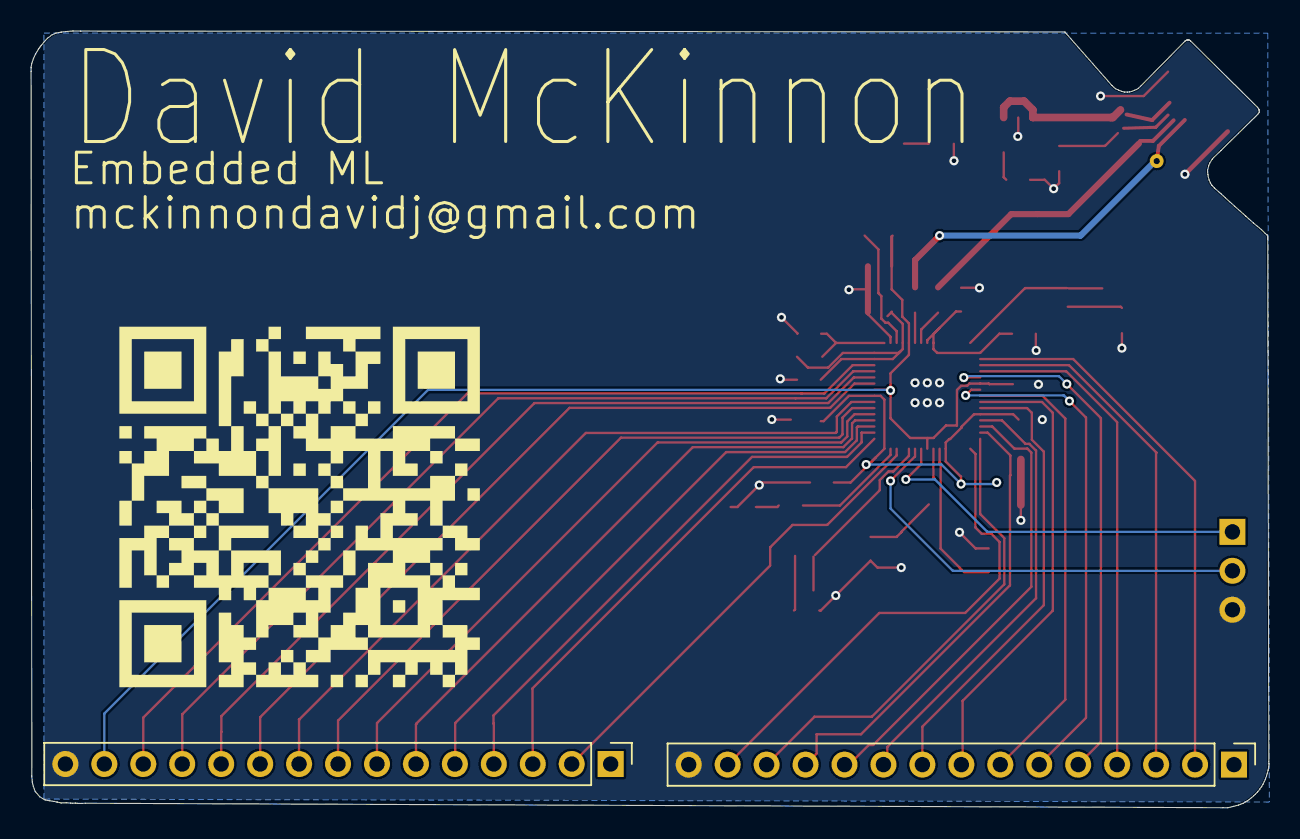
[picture p8: board RP2354.kicad_pcb from below]

Board: 2 copper layers, 80.7 x 50.6 mm, 38 parts (2 on the bottom side), 48 nets.

Other parts of the board:
BOOTSEL: SW_Push; SW_1P1S_SMD
RESET: SW_Push; SW_1P1S_SMD

Their connections:
unnamed 39: RESET.2; also elsewhere on the board
unnamed 40: BOOTSEL.2; also elsewhere on the board
unnamed 41: RESET.1; also elsewhere on the board
unnamed 47: BOOTSEL.1; also elsewhere on the board
